USCAUV-Embedded-Systems/Power-Board-PCB/Power Board.pdf

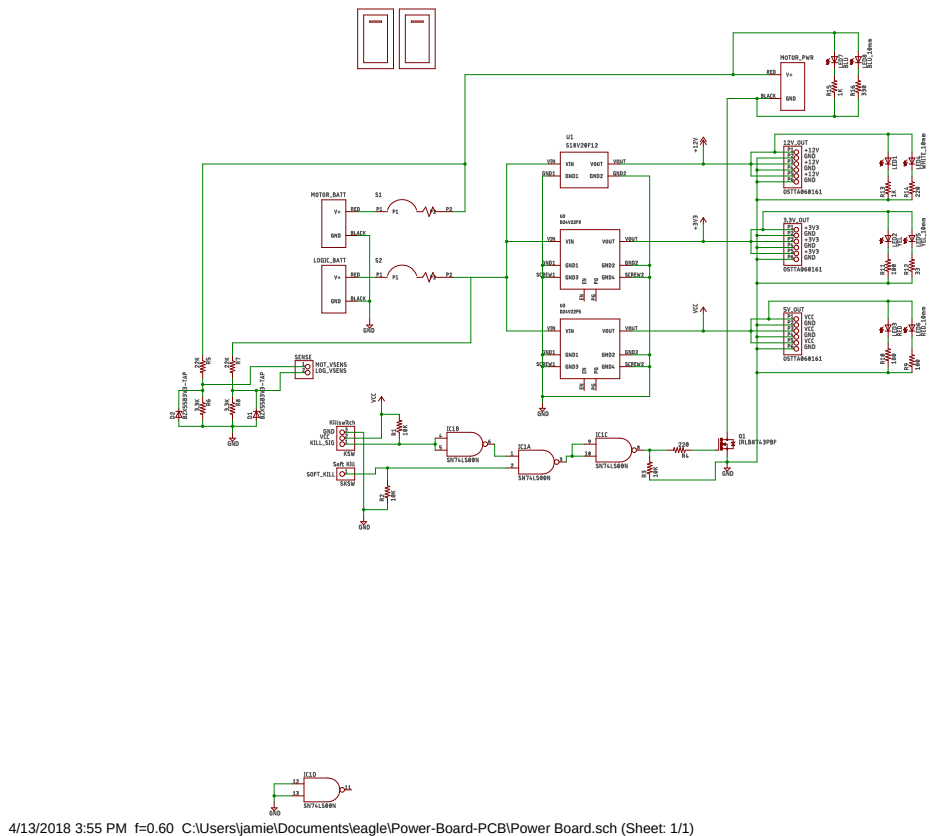
[picture p1: page 1]

4/13/2018 3:55 PM f=0.60 C:\Users\jamie\Documents\eagle\Power-Board-PCB\Power Board.sch (Sheet: 1/1)
