USCAUV-Embedded-Systems/Power-Board-PCB/Power Board.brd

## EAGLE design Power Board.brd (2019-03-20)

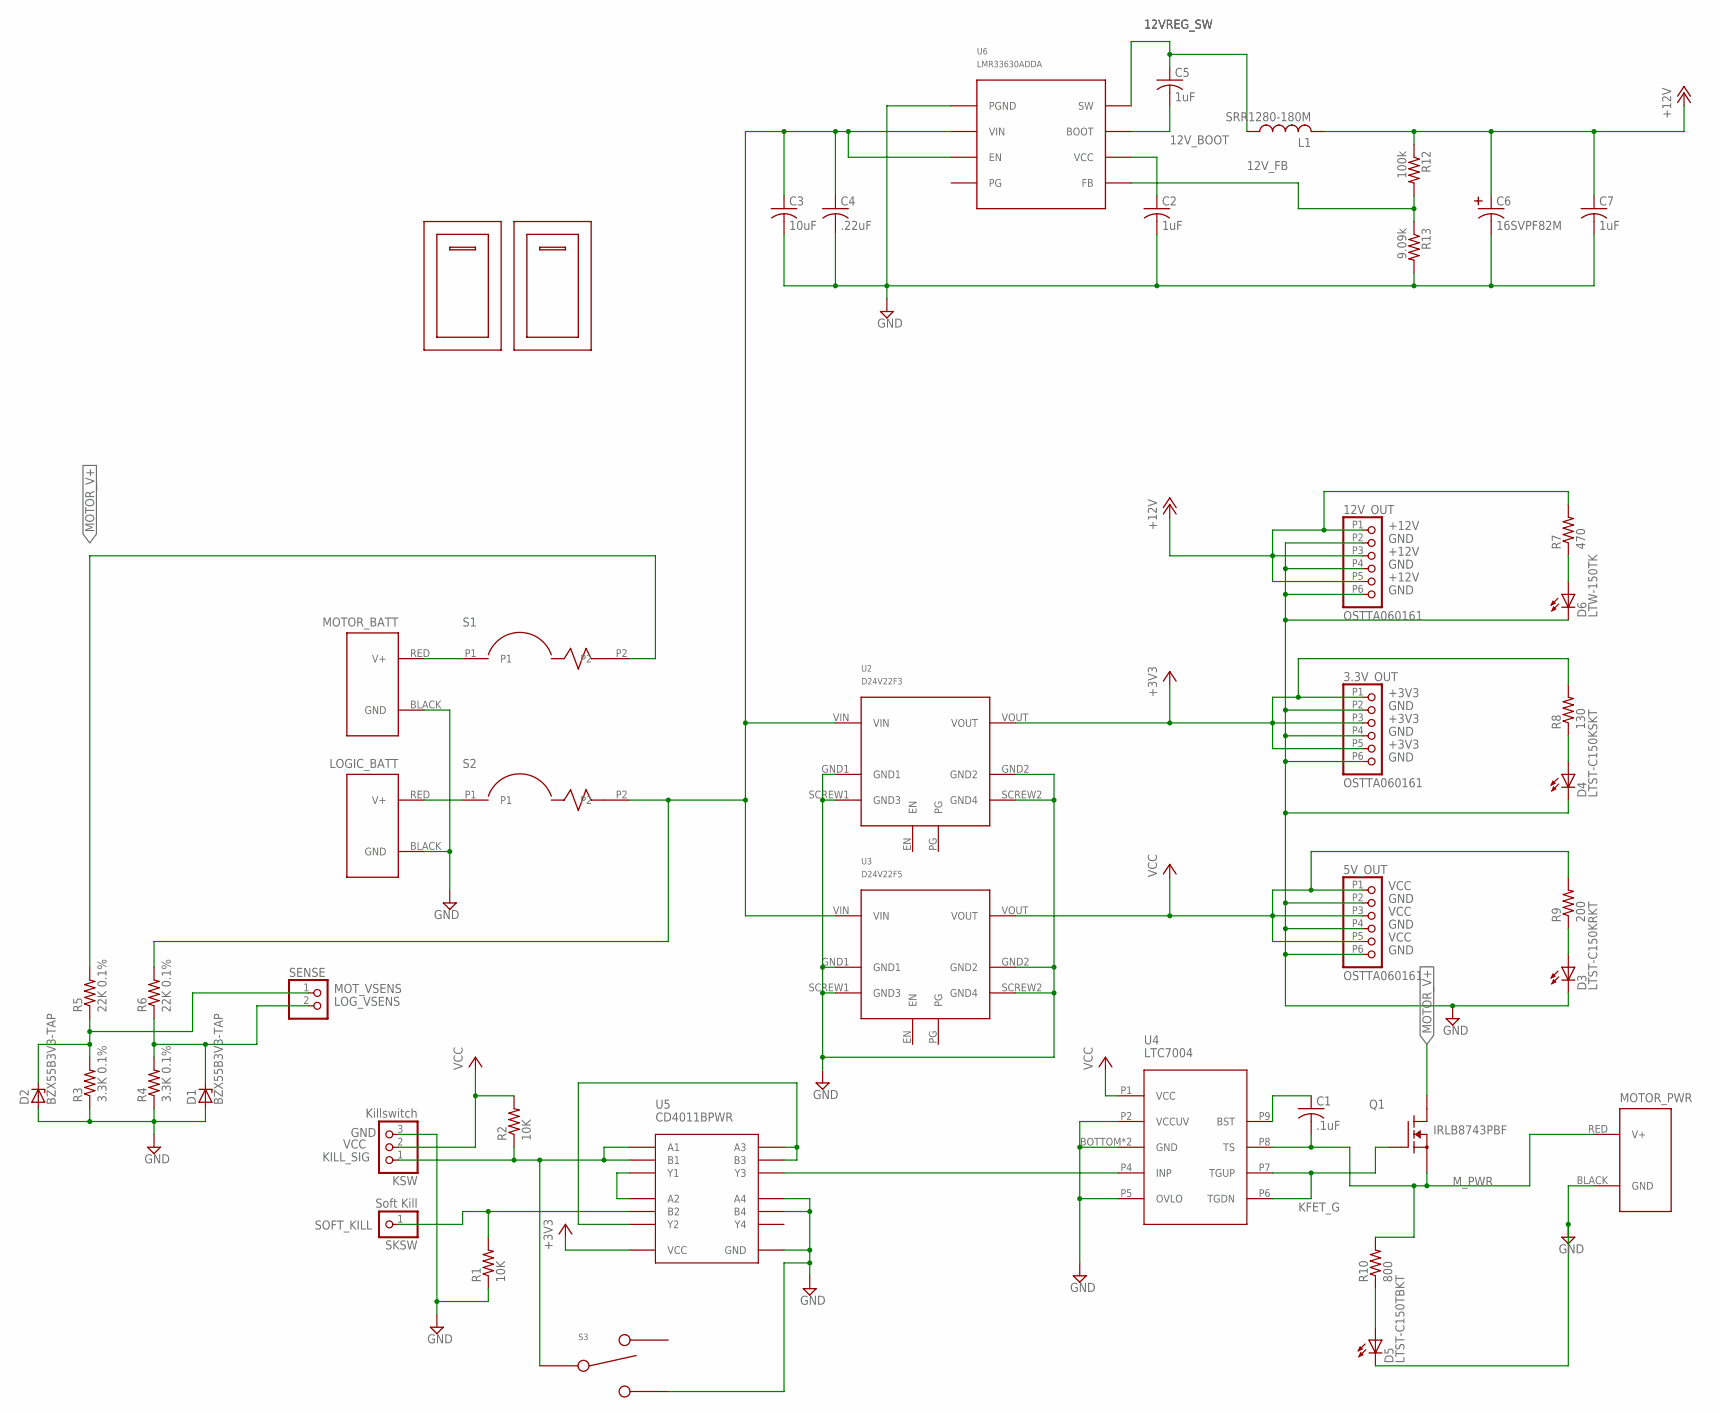
[picture p2: schematic Power Board.sch]

Parts:
3.3V_OUT, 5V_OUT, 12V_OUT: OSTTA060161; OSTTA06
C1: .1uF; C1206
C2, C5, C7: 1uF; C1206
C3: 10uF; C1206
C4: .22uF; C1206
C6: 16SVPF82M
D1, D2: BZX55B3V3-TAP; DO34Z7
D3: LTST-C150KRKT; LITEON_LED_1206
D4: LTST-C150KSKT; LITEON_LED_1206
D5: LTST-C150TBKT; LITEON_LED_1206
D6: LTW-150TK; LITEON_LED_1206
KSW: Killswitch; 1X03
L1: SRR1280-180M; SRR1280
LOGIC_BATT: POWERPOLE_POWER10AWG; POWERPOLE_PAIR_10AWG
MOTOR_BATT: POWERPOLE_POWER10AWG; POWERPOLE_PAIR_10AWG
MOTOR_PWR: POWERPOLE_POWER10AWG; POWERPOLE_PAIR_10AWG
Q1: IRLB8743PBF; TO220
R1, R2: 10K; R1206
R3, R4: 3.3K 0.1%; R1206
R5, R6: 22K 0.1%; R1206
R7: 470; R1206
R8: 130; R1206
R9: 200; R1206
R10: 800; R1206
R12: 100k; R1206
R13: 9.09k; R1206
S1, S2: W51-A152A1-20; W51-A152A1-PINS
S3: OS102011MS2QN1; OS102011MS2Q
SENSE: PINHD-1X2; 1X02
SKSW: Soft Kill; 1X01
U2: D24V22F3; D24V22
U3: D24V22F5; D24V22
U4: LTC7004; 10-MSOP
U5: CD4011BPWR; 14-TSSOP
U6: LMR33630ADDA; HSOIC-8-POWERPAD
U$1, U$2: W51-A152A1-20-CUTOUT; W51-A152A1-CUTOUT

Connections:
12VREG_SW: C5.1, L1.1, U6.8 (SW)
12V_BOOT: C5.2, U6.7 (BOOT)
12V_FB: R12.2, R13.1, U6.5 (FB)
+3V3: 3.3V_OUT.P1 (1), 3.3V_OUT.P3 (3), 3.3V_OUT.P5 (5), R8.2, U2.VOUT, U5.P14 (VCC)
+12V: 12V_OUT.P1 (1), 12V_OUT.P3 (3), 12V_OUT.P5 (5), C6.POS, C7.1, L1.2, R7.2, R12.1
GND: 3.3V_OUT.P2 (2), 3.3V_OUT.P4 (4), 3.3V_OUT.P6 (6), 5V_OUT.P2 (2), 5V_OUT.P4 (4), 5V_OUT.P6 (6), 12V_OUT.P2 (2), 12V_OUT.P4 (4), 12V_OUT.P6 (6), C2.2, C3.2, C4.2, C6.NEG, C7.2, D1.A, D2.A, D3.C, D4.C, D5.C, D6.C, KSW.3, LOGIC_BATT.BLACK (GND), MOTOR_BATT.BLACK (GND), MOTOR_PWR.BLACK (GND), R1.1, R3.1, R4.1, R13.2, S3.L, U2.GND1, U2.GND2, U2.SCREW1 (GND3), U2.SCREW2 (GND4), U3.GND1, U3.GND2, U3.SCREW1 (GND3), U3.SCREW2 (GND4), U4.BOTTOM (GND), U4.P2 (VCCUV), U4.P3 (GND), U4.P5 (OVLO), U5.P7 (GND), U5.P12 (A4), U5.P13 (B4), U6.1 (PGND), U6.THERMAL (PGND)
KFET_G: Q1.G, U4.P6 (TGDN), U4.P7 (TGUP)
KILL_SIG: KSW.1, R2.1, S3.C, U5.P1 (A1), U5.P2 (B1)
LOG_BATT_VIN: LOGIC_BATT.RED (V+), S2.P1
LOG_VIN: C3.1, C4.1, R6.2, S2.P2, U2.VIN, U3.VIN, U6.2 (VIN), U6.3 (EN)
LOG_VSENS: D1.C, R4.2, R6.1, SENSE.2
MOTOR_V+: Q1.D@1 (D), Q1.D@2 (D), R5.2, S1.P2
MOT_BATT_VIN: MOTOR_BATT.RED (V+), S1.P1
MOT_VSENS: D2.C, R3.2, R5.1, SENSE.1
M_PWR: C1.2, MOTOR_PWR.RED (V+), Q1.S, R10.2, U4.P8 (TS)
unnamed: D6.A, R7.1
unnamed: U5.P3 (Y1), U5.P5 (A2)
unnamed: U5.P4 (Y2), U5.P8 (A3), U5.P9 (B3)
unnamed: U4.P4 (INP), U5.P10 (Y3)
unnamed: D4.A, R8.1
unnamed: D3.A, R9.1
unnamed: D5.A, R10.1
unnamed: C2.1, U6.6 (VCC)
unnamed: C1.1, U4.P9 (BST)
SOFT_KILL: R1.2, SKSW.1, U5.P6 (B2)
VCC: 5V_OUT.P1 (1), 5V_OUT.P3 (3), 5V_OUT.P5 (5), KSW.2, R2.2, R9.2, U3.VOUT, U4.P1 (VCC)

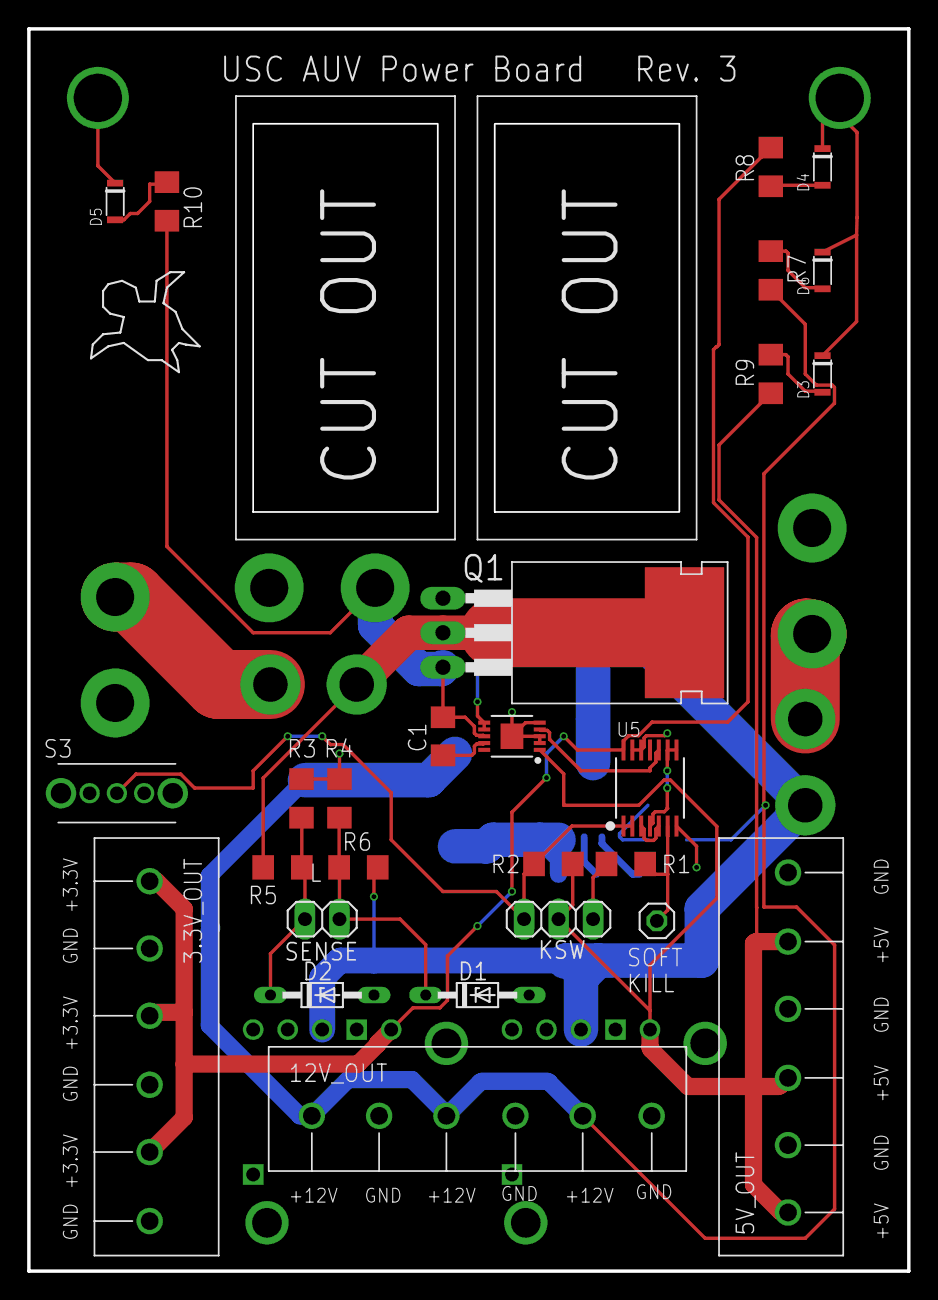
[picture p3: board Power Board.brd from above]

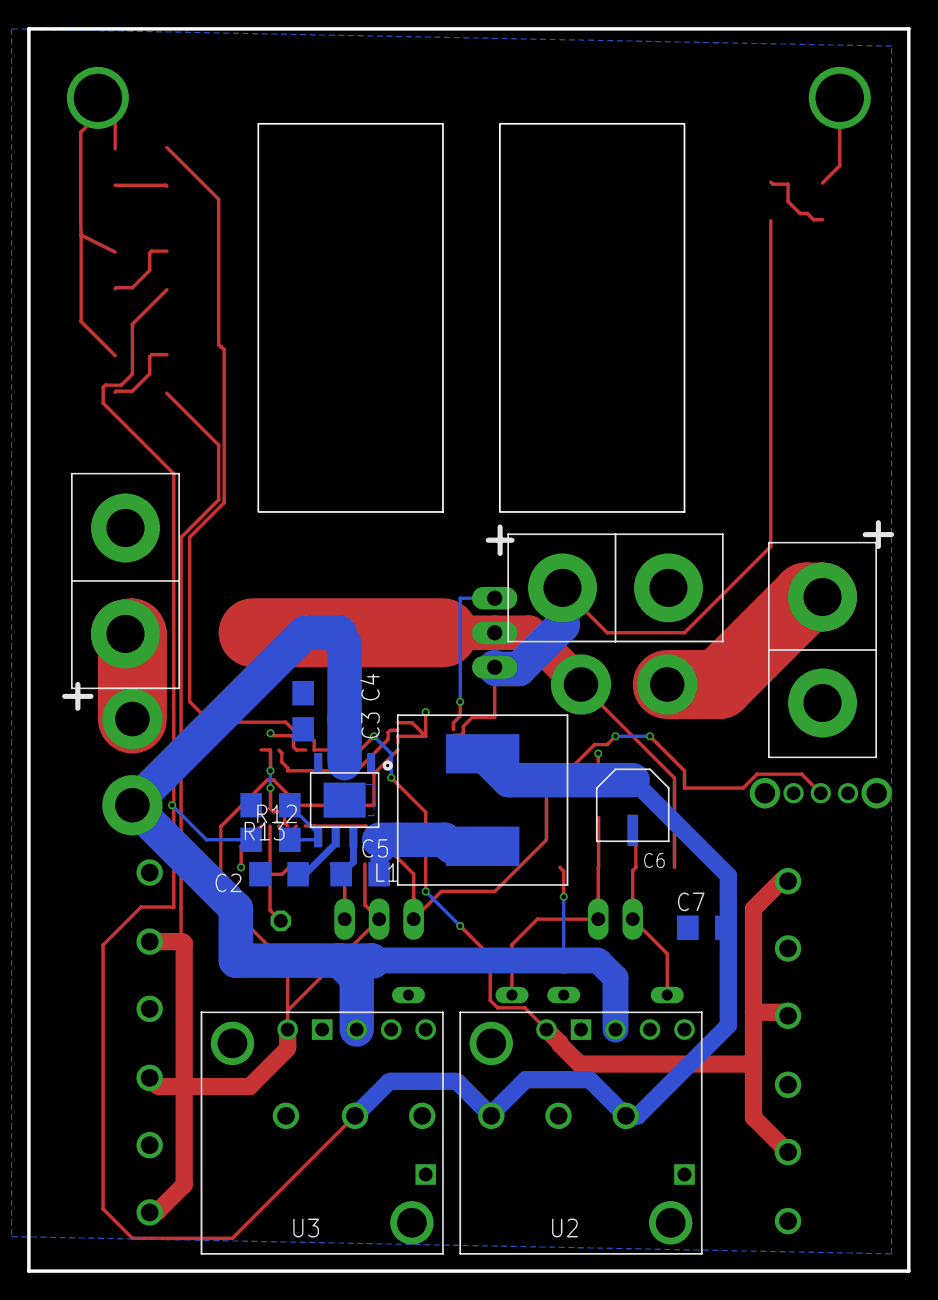
[picture p4: board Power Board.brd from below]

Board: 2 copper layers, 64.8 x 91.4 mm, 46 parts (15 on the bottom side), 26 nets.
