USCAUV-Embedded-Systems/Power-Board-PCB/(commit log)

2018-02-02 Initial commit, schematic done, need to make layout still
    [Power Board.brd, Power Board.sch]
2018-02-02 Route PCB
    [Power Board.brd, Power Board.sch]
2018-02-03 Add missing powerpoles.lbr
2018-02-03 Fix some routing issues for submission to PCB manufacturer
    [Power Board.brd, Power Board.sch]
2018-04-30 Remove large LEDs (they were too hard to find, and produced too much heat)
    [Power Board.brd, Power Board.sch]
2018-11-06 Start on new SMD version of power board -- add LTC FET driver, convert NAND gate to SMD
    [Power Board.brd, Power Board.sch]
2018-11-20 Switch LEDs to surface mount, add LTC MOSFET driver
    [Power Board.brd, Power Board.sch]
2019-01-09 Changes to power board
2019-01-09 Add Simple Switcher 5V regulator design (still needs to be CADed)
    [Power Board.brd, Power Board.sch, WBBOMDesign9.csv]
2019-03-06 Reroute top of board for new surface-mount parts
    [Power Board.brd, Power Board.sch]
2019-03-06 Done with Simple Switcher-based voltage regulator
    [Power Board.brd, Power Board.sch]
2019-03-20 Change 800 ohm resistor to 1K
    [Power Board.brd]
